phopley/rodney-project/Articles/tensorflow/test_image.jpg

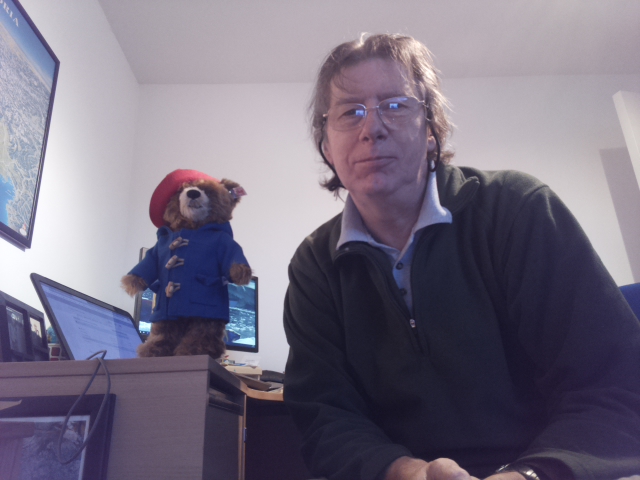
Articles/tensorflow/test_image.jpg
