phopley/rodney-project/Articles/tensorflow/Opt-person_dog.png

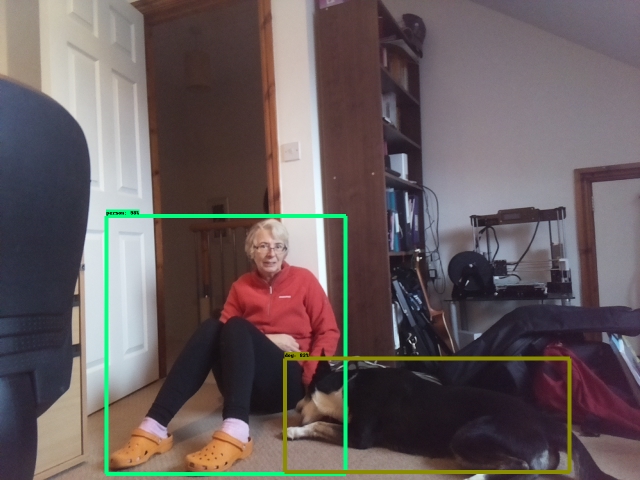
Articles/tensorflow/Opt-person_dog.png
