phopley/rodney-project/README.md

# rodney-project
Documentation for the Rodney House Robot project using ROS (Robot Operating System).

Please see the [project wiki](https://github.com/phopley/rodney-project/wiki) for more information
