phopley/rodney-project/Articles/Part08/pi_image.md

# Instructions for creating the Raspberry Pi image
## Introduction
These steps will guide you through the process of installing and setting up the Rapberry Pi image for the Rodney project. We will use a free lbuntu image from Ubiquity Robotics. This image included ROS Kinetic and there own ROS packages like raspicam_node.

In the guide we will
* [Obtain and copy the Ubiquity Robotics Pi image](https://github.com/phopley/rodney-project/blob/master/Articles/Part08/pi_image.md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)
* [Configure and update the image](https://github.com/phopley/rodney-project/blob/master/Articles/Part08/pi_image.md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)
* N/A
* [Setup Bluetooth](https://github.com/phopley/rodney-project/blob/master/Articles/Part08/pi_image.md#4-setup-bluetooth)
* [Configure the System](https://github.com/phopley/rodney-project/blob/master/Articles/Part08/pi_image.md#5-configure-the-system)
* [Install Homer Robot Face](https://github.com/phopley/rodney-project/blob/master/Articles/Part08/pi_image.md#6-install-homer-robot-face)
* [Install Voice Applications](https://github.com/phopley/rodney-project/blob/master/Articles/Part08/pi_image.md#7-install-voice-applications)
* [Install ROS pakages used by Rodney](https://github.com/phopley/rodney-project/blob/master/Articles/Part08/pi_image.md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)
* [Setup a Swapfile](https://github.com/phopley/rodney-project/blob/master/Articles/Part08/pi_image.md#9-setup-a-swapfile)
* [Install simple-pid](https://github.com/phopley/rodney-project/blob/master/Articles/Part08/pi_image.md#10-install-simple-pid)

## Steps
### 1. Obtain and copy the Ubiquity Robotics Pi image
Here we will download and install the image.
- [ ] Download the lastest ROS image from the Ubiquity Robotics web site https://downloads.ubiquityrobotics.com/pi.html. The last image I used was 2019-02-19-ubiquity-xenial-lxde-raspberry-pi.img.xz
- [ ] Unzip the image.
- [ ] Format a 16GB SD card. I use SD Card Formatter to format the card.
- [ ] Copy the unzipped image to the SD card. I use Win32DiskImager to create the image on an SD card.
- [ ] Boot the Pi from the SD card. When the Raspberry Pi boots for the first time it resizes the file system to fill the SD card. This can make the first boot take some time.
- [ ] Login to the Pi. The user name is 'ubuntu' and the password is 'ubuntu'.
### 2. Configure and update the image
- [ ] The image comes with a WiFi access point. The SSID is ubiquityrobotXXXX where XXXX is part of the MAC address, the wifi password is robotseverywhere. Since I'm developing an house robot I prefer to connect to my home Wi-Fi. Disconnect the WiFi from the access point and connect to the home WiFi network. SSH is enabled so it is possible to remotley login.
- [ ] There is an Ubiquity Robotics script designed for their own robots. Disable the script with the following shell command.
```
$ sudo systemctl disable magni-base
```
- [ ] Run the following commands to get the latest updates.
```
$ sudo apt-get update
$ sudo apt-get upgrade
$ sudo apt-get dist-upgrade
$ sudo reboot now
```
### 3. N/A
### 4. Setup Bluetooth
I like to use a small Bluetooth keyboard with the robot. In this image the Bluetooth is enabled correctly.
- [ ] Pair the device.
### 5. Configure the System
The following configures the lbunutu desktop and system for how I like it for a robot.
- [ ] So that you only have to touch 'login' on the screen and not enter a password to login select from the menu "System Tools -> Users and Groups", change to Password "Not asked on login"
- [ ] Although the image includes Firefox I like to install Chromium with:
```
$ sudo apt install chromium-browser
```
- [ ] I don't want the screen saver or power managment to kick in so from the menu "Preferences->Power Manager" select
* System tab - When inactive for -> never
* Display tab - Blank after -> never
* Display tab - Put to sleep after - > never
* Display tab - switch off after -> never
* Security tab - Automatically lock the session : Never
- [ ] You may want to change the user password.
- [ ] I like to set the following panel applets to my choice. Right click on bar and select "Add/Remove Panel Items" and select:
* Menu
* Directory Menu - "/home/ubuntu"
* Application Launch and Task Bar (stretch) - Chromium Web Browser
* System Tray
* Indicator applets
* Digital Clock
### 6. Install Homer Robot Face
The Homer Robot Face ROS package is used to display an animated robot face.
- [ ] Install the homer_robot_face package
```
$ sudo apt-get install ros-kinetic-homer-robot-face
```
- [ ] There is a problem with a directory path. The code expects the OGRE to be in the directory `/usr/lib/x86_64-linux-gnu/OGRE-1.9.0` but as you would expect on a Raspberry Pi it's in `/usr/lib/arm-linux-gnueabihf/OGRE-1.9.0` We can solve this problem by creating a symbolic link
```
$ cd /usr/lib
$ sudo mkdir -p x86_64-linux-gnu
$ sudo ln -s /usr/lib/arm-linux-gnueabihf/OGRE-1.9.0 /usr/lib/x86_64-linux-gnu
```
- [ ] You can configer the face by editing the robot_homer_face config.cfg file
```
sudo nano /opt/ros/kinetic/share/homer_robot_face/config/config.cfg
```
* Mesh Filename : GiGo
* Head Color : 1.0, 1.0, 1.0
* Iris Color : 0.0, 1.0, 1.0
* Outline Color : 0.0, 0.0, 0.0
* Voice : male
* Window Width : 400
* Window Height : 450
* Window Rotation : 0
- [ ] To centre the face when running. Edit the lubuntu-rc.xml file and add the following application tag inside the applications tag
```
$ cd ~/
$ nano .config/openbox/lubuntu-rc.xml
```
``` xml
        <application name="RobotFace">
            <position force="yes">
                <x>200</x>
                <y>0</y>
            </position>
        </application>
</applications>
</openbox_config>
```
### 7. Install Voice Applications
The applications `pico2wav` and `Sox` are used by Rodney.
- [ ]  Install pico2wav with the following command:
```
$ sudo apt-get install libttspico-utils
```
- [ ] Install Sox with the following command:
```
sudo apt-get install sox libsox-fmt-all
```
### 8. Install ROS pakages used by Rodney
The following ROS packages are also used by Rodney and can be download and installed/compiled.
- [ ] I usually use the directory ~/rondey_ws for the ROS wokspace, add it to the bash file with the following
```
$ cd ~/
$ nano .bashrc
```
* Add "source /home/ubuntu/rodney_ws/devel/setup.bash" to the end of the file, save and exit
- [ ] Install the rosserial package so that the Arduino or Teensy can be used
```
$ sudo apt-get install ros-kinetic-rosserial
```
- [ ] Install the laser_filters package so that we can bound the LIDAR scan
```
$ sudo apt-get install ros-kinetic-laser-filters
```
- [ ] Install the robot_localization package
```
$ sudo apt-get install ros-kinetic-robot-localization
```
- [ ] Install the map_server, amcl packages
```
$ sudo apt-get install ros-kinetic-map-server ros-kinetic-amcl
```
- [ ] Install the global and local planners
```
$ sudo apt-get install ros-kinetic-global-planner ros-kinetic-dwa-local-planner
```
- [ ] Rodney use the ros-keyboard package for keyboard teleop. It requires SDL version 1.2. If you just try to install SDL you will get a later version and the package will not build. Use the following commands to download the package from https://github.com/lrse/ros-keyboard and use rosdep to ensure the correct dependencies are installed before building it with catkin_make.
* Note - I have assumed the package was download to ~/git/ros-keyboard
```
$ mkdir -p ~/temp_ws/src
$ cd ~/temp_ws
$ catkin_make
$ ln -s ~/git/ros-keyboard ~/temp_ws/src
$ rosdep update
$ rosdep install --from-paths src --ignore-src --rosdistro kinetic -y
$ catkin_make
```
### 9. Setup a Swapfile
As the project develops and increases in size a swapfile is required when building the project. Create a 1GB swapfile with the following command:
```
$ cd /
$ sudo dd if=/dev/zero of=swapfile bs=1M count=1000
$ sudo mkswap swapfile
$ sudo swapon swapfile
$ sudo nano etc/fstab
```
* Add "/swapfile none swap sw 0 0" to the end of the file , save and exit
### 10. Install simple-pid
The thunderborg node uses the simple-pid https://pypi.org/project/simple-pid/
This can be installed with
```
$ pip install simple-pid
```
