phopley/rodney-project/Articles/Part03/Opt-IMG_0395.JPG

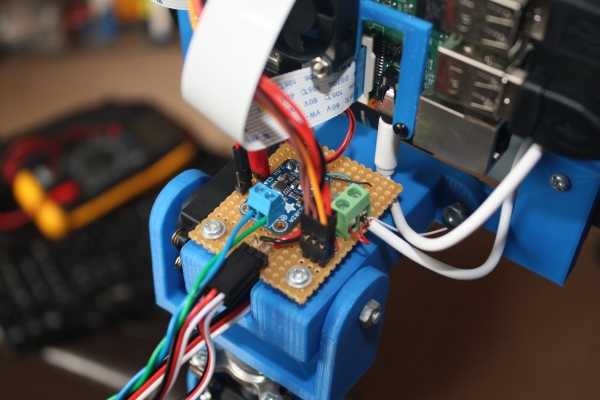
Articles/Part03/Opt-IMG_0395.JPG
