phopley/rodney-project/Articles/Part03/Opt-IMG_0396.JPG

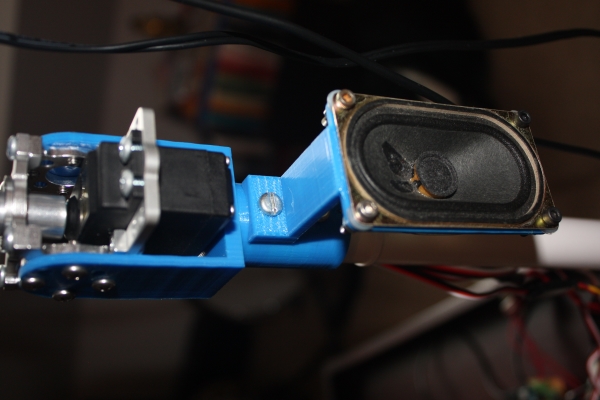
Articles/Part03/Opt-IMG_0396.JPG
