phopley/rodney-project/Articles/Part03/Opt-rodney_face.png

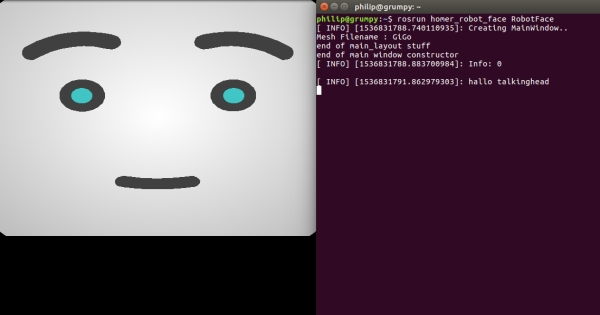
Articles/Part03/Opt-rodney_face.png
