phopley/rodney-project/Articles/Part03/Opti-reconfigure_speech_node.png

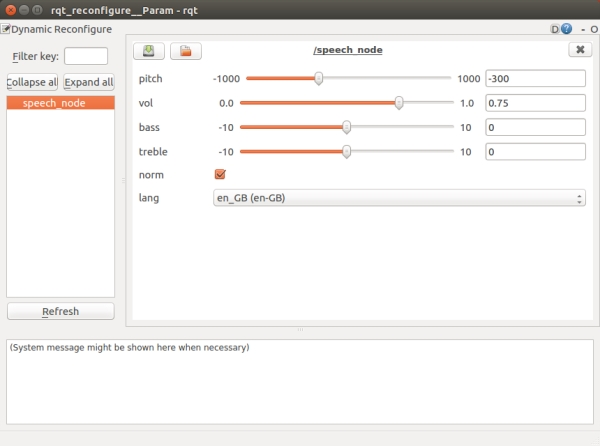
Articles/Part03/Opti-reconfigure_speech_node.png
