phopley/rodney-project/Articles/Part03/Opti-sim01.png

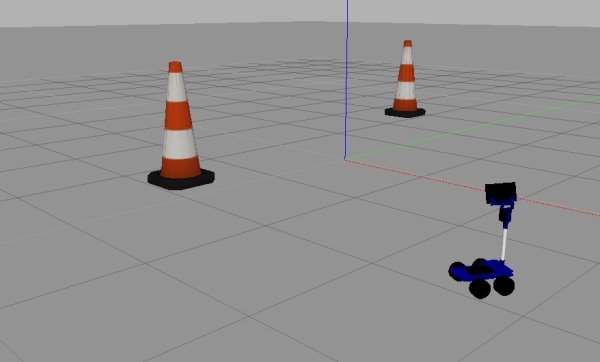
Articles/Part03/Opti-sim01.png
