phopley/rodney-project/Articles/Part05/Optimized-IMG_0496.JPG

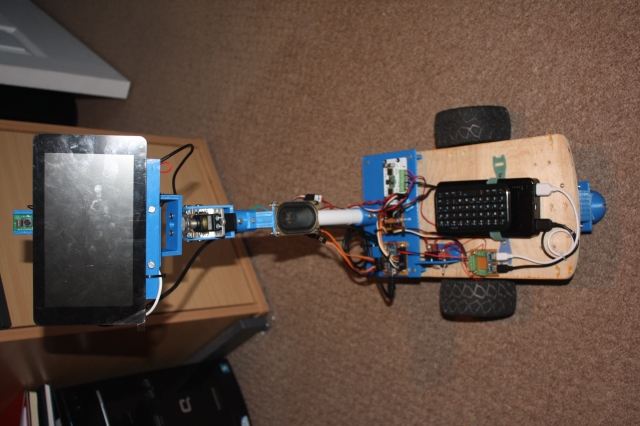
Articles/Part05/Optimized-IMG_0496.JPG
