phopley/rodney-project/Articles/Part08/Opti-smach_mission1.png

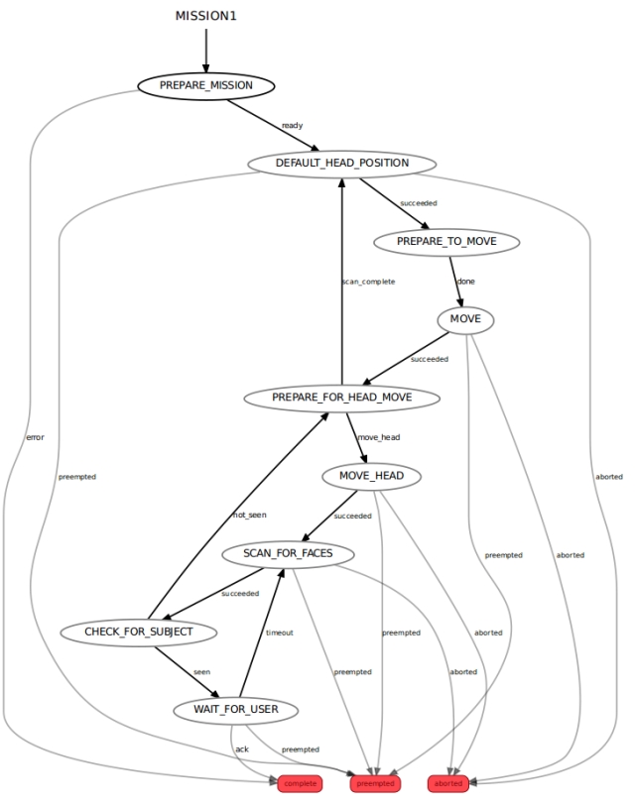
Articles/Part08/Opti-smach_mission1.png
