phopley/rodney-project/Articles/Part08/Opti-smach_mission4.png

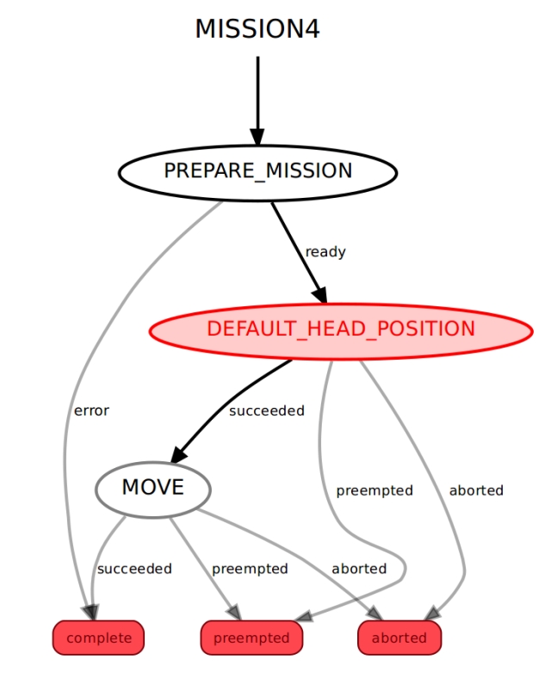
Articles/Part08/Opti-smach_mission4.png
