phopley/rodney-project/Articles/tensorflow/Opt-rosgraph.png

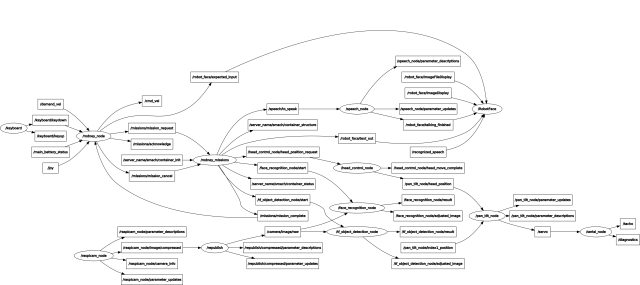
Articles/tensorflow/Opt-rosgraph.png
