phopley/rodney-project/Articles/tensorflow/rosgraph.png

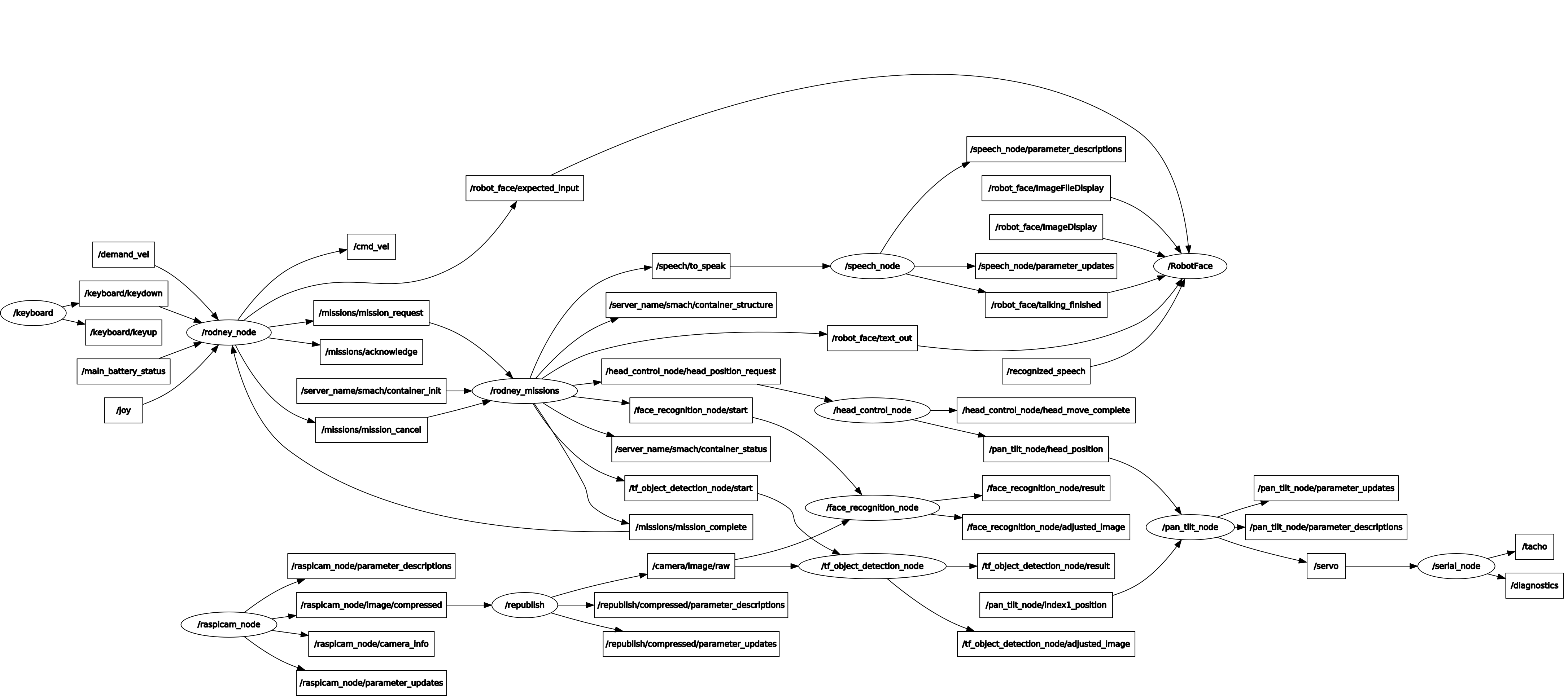
Articles/tensorflow/rosgraph.png
