phopley/rodney-project/Articles/tensorflow/tensorwordcloud.jpg

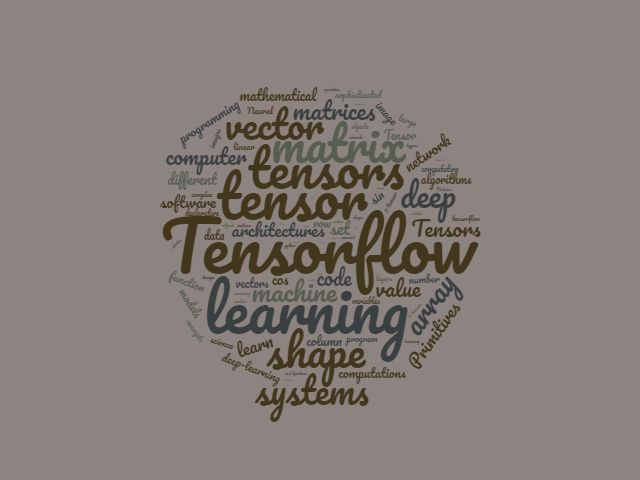
Articles/tensorflow/tensorwordcloud.jpg
