phopley/rodney-project/Articles/Part05/bom.md

# Rodney Robot BOM (Article Part 5)
| Item | No. | Approx Cost |
| --- | ----| --- |
| [3D Print Camera bracket](https://github.com/phopley/rodney-project/blob/master/hardware/3D%20Prints/camera%20bracketV2.stl) | x1 | |
| [3D Print Caster](https://github.com/phopley/rodney-project/blob/master/hardware/3D%20Prints/pingpongwheelBeefy.stl) | x2 |  |
| [3D Print Caster Spacer](https://github.com/phopley/rodney-project/blob/master/hardware/3D%20Prints/casterspacer2.stl) | x2 |  |
| [3D Print Display Bracket](https://github.com/phopley/rodney-project/blob/master/hardware/3D%20Prints/display%20bracket_vb.stl) |x1| |
| [3D Print Fan Bracket](https://github.com/phopley/rodney-project/blob/master/hardware/3D%20Prints/fan_bracket.stl) | x1 | |
| [3D Print Head Fixing Bracket](https://github.com/phopley/rodney-project/blob/master/hardware/3D%20Prints/head%20fixing.stl) | x1 |  |
| [3D Print Head Pan Bracket](https://github.com/phopley/rodney-project/blob/master/hardware/3D%20Prints/pan%20bracket_vb.stl) | x1 |  |
| [3D Print Head Tilt Arm](https://github.com/phopley/rodney-project/blob/master/hardware/3D%20Prints/tilt%20arm_vb.stl) | x1 | | 
| [3D Print Rear Platform](https://github.com/phopley/rodney-project/blob/master/hardware/3D%20Prints/smallRearPlatform.stl) | x1 |  |
| [3D Print Rear Platform Standoff](https://github.com/phopley/rodney-project/blob/master/hardware/3D%20Prints/platformStandoffs23.stl) | x4 |  |
| [3D Print Speaker Bracket](https://github.com/phopley/rodney-project/blob/master/hardware/3D%20Prints/speaker_bracket.stl) | x1 | |
| [3D Print Switch Bracket](https://github.com/phopley/rodney-project/blob/master/hardware/3D%20Prints/switchBracket.stl)| x1 |  |
| 16GB Miscro SD Card | x1  |  £8.00 |
| [2 Pole 5mm Pitch PCB Mount Screw Terminal Block](https://www.amazon.co.uk/20Pcs-Pitch-Mount-Screw-Terminal-Green/dp/B00I00OHHY)| Pack 20  | £1.45 |
| 21.5mm PVC Pipe (used for neck) | | £1.89 for 2 metres  |
| 6-32 UNC x 5/16 inch Pan Head Screws (Head Bracket to Load Bearing Block) | x8 | |
| 8 Ohm Speaker | x1  | |
| AA Rechargeable Batteries | x10 | |
| [Adafruit Mono 2.5W Class D Audio Amplifier PAM8302](https://thepihut.com/products/adafruit-mono-2-5w-class-d-audio-amplifier-pam8302) | x1  | £4 |
| [Advanced Motor Bracket Mount (large)](https://www.modmypi.com/motors-mounts-and-wheels-1140/advanced-motor-bracket-mount-large) | x2  | £7.98 |
| [Arduino Nano](https://uk.rs-online.com/web/p/products/6961667) | x1  |  £19.26 |
| Assorted 3-pin Female/Female cables | | | 
| Audio lead | x1  | |
| Base - plywood board 340x180x8 mm | x1  | |
| [Battery Holder (10 x AA)](https://www.modmypi.com/raspberry-pi/robotics-and-motor-controllers-392/battery-snaps-and-boxes-1165/10aa-holder) | x1 | £3.00 |
| Black Cable Ties 2.5mm | Pack 100 |  £0.79 |
| [Brass Motor Shaft Hub - 6mm](https://www.modmypi.com/motors-mounts-and-wheels-1140/hub-6mm) | x2  | £3.98 |
| [Load Bearing Servo block (Futaba)](https://www.robotshop.com/uk/load-bearing-servo-block-futaba.html)| x1  | £26.78 |
| [Metal DC Geared Motor w/Encoder - 12V 122RPM 38Kg.cm](https://thepihut.com/products/metal-dc-geared-motor-w-encoder-12v-122rpm-38kg-cm)| x2  | £62 |
| Micro USB Breakout Board | x2 |  |
| Micro USB Power Cables | x2 |  |
| [Mini Bluetooth Keyboard](https://www.amazon.co.uk/Remaxm-Rechargeable-Bluetooth-Keyboards-Raspberry/dp/B07M7VQVDJ/) | x1 | £7.51 |
| [Miniature 5V Cooling Fan for Pi](https://thepihut.com/products/adafruit-miniature-5v-cooling-fan-for-raspberry-pi-and-other-computers)| x1  | £3.50 |
| Pi/Nano USB Cable | x1  | |
| [Raspberry Pi 3 7" Touchscreen Display](https://thepihut.com/products/official-raspberry-pi-7-touchscreen-display)| x1  | £60.00 |
| [Raspberry Pi 3, Model B, 1GB RAM](https://thepihut.com/collections/raspberry-pi/products/raspberry-pi-3-model-b)| x1  |  £32.00|
| [Raspberry Pi Camera Board V2](https://www.modmypi.com/pis-and-peripherals-1139/raspberry-pi-camera-board-v2-8mp1080p)| x1  | £24.50 |
| [Raspberry Pi Heatsink - Black](https://thepihut.com/products/raspberry-pi-heatsink)| x1  | £1 |
| [RC Servo Futaba S3003](https://www.modmypi.com/raspberry-pi/robotics-and-motor-controllers-392/motors-1022/servo-motor-futaba-s3003-multi-purpose-standard-size) | x1  | £7.00 |
| [RC Servo Futaba S3305 Heavy Duty Metal Gear](https://www.servoshop.co.uk/index.php?pid=FUTS3305&area=Servo) | x1 | £36.99 |
| Screw button head hex M2.5 x 16mm (fan bracket to Pi) | x2 | |
| [Single Row 40 Pin 2.54 mm Male Pin Header Connector](https://www.amazon.co.uk/Pack-Single-2-54-Header-Connector/dp/B06XR8CV8P) | Pack 50 | £5.85 |
| Switch - Rocker single pole | x1 | |
| Switch - Toggle double pole | x1 | |
| Table Tennis Balls | x2|  |
| [Thunderborg - Dual 5A Motor Controller with DC/DC & RGB LED](https://www.modmypi.com/motor-control-1135/thunderborg)| x1  | £37.00 |
| USB Power Bank, 2 port (2.1A, 1.0A) | x1 | |
| Various general screws/nuts/standoffs |  |  |
| Velcro Straps | | | 
| Veroboard - various | | |
| [Wheel Pair in Black (105x50mm)](https://www.modmypi.com/motors-mounts-and-wheels-1140/wheel-pair-in-black-105mm-x-50mm-) | x1 | £11.99|

[The Pi Hut](https://thepihut.com/)  
[ModMyPi](https://www.modmypi.com/)  
[Servo Shop](https://www.servoshop.co.uk/index.php)  
[Robot Shop](https://www.robotshop.com/uk/)  
[RS Components](https://uk.rs-online.com/web/)  
[Amazon](https://www.amazon.co.uk)
