phopley/rodney-project/hardware/3D Prints/push_button_bracket.stl

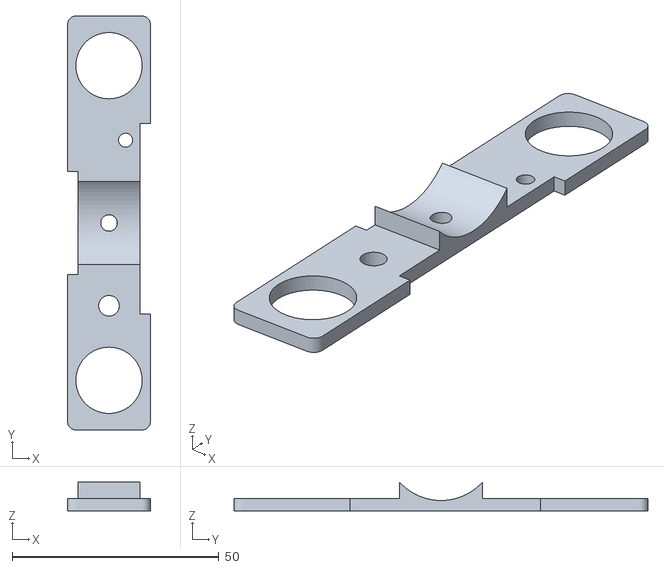
[picture p73: CAD file, 2019-04-29]
hardware/3D Prints/push_button_bracket.stl
20.0 x 100.0 x 6.93
