phopley/rodney-project/hardware/3D Prints/imu_support.stl

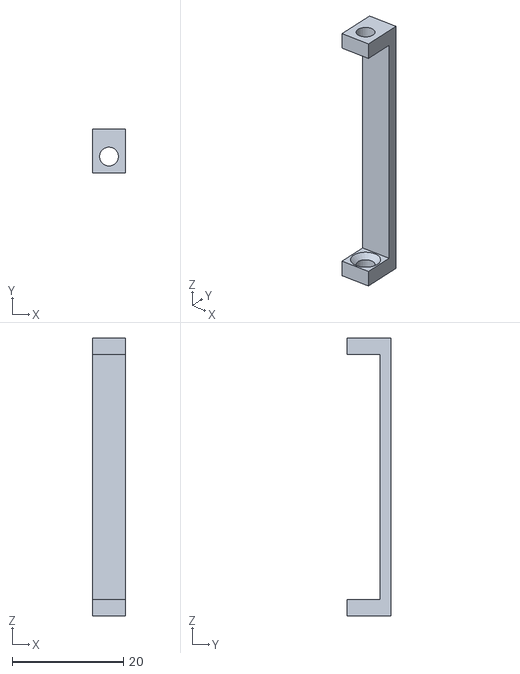
[picture p74: CAD file, 2019-04-09]
hardware/3D Prints/imu_support.stl
6.00 x 8.00 x 50.0
