phopley/rodney-project/hardware/3D Prints/imu_bracket.stl

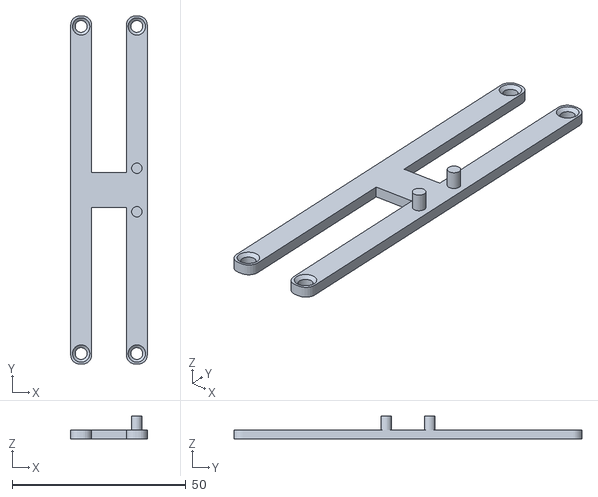
[picture p75: CAD file, 2019-04-09]
hardware/3D Prints/imu_bracket.stl
22.0 x 100.0 x 6.50
