phopley/rodney-project/hardware/3D Prints/fwdPlatform.stl

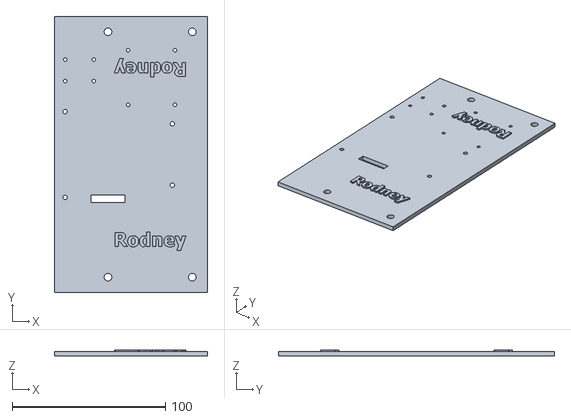
[picture p76: CAD file, 2019-03-01]
hardware/3D Prints/fwdPlatform.stl
100.0 x 180.0 x 4.00
