phopley/rodney-project/hardware/3D Prints/FwdPlatformStandoffs.stl

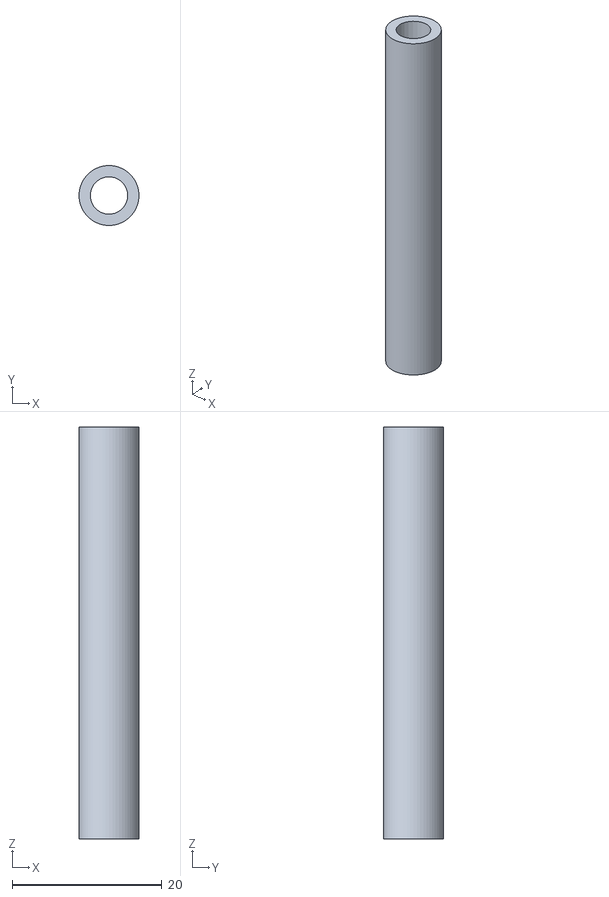
[picture p77: CAD file, 2019-02-13]
hardware/3D Prints/FwdPlatformStandoffs.stl
8.00 x 8.00 x 55.0
