phopley/rodney-project/hardware/3D Prints/smallRearPlatform.stl

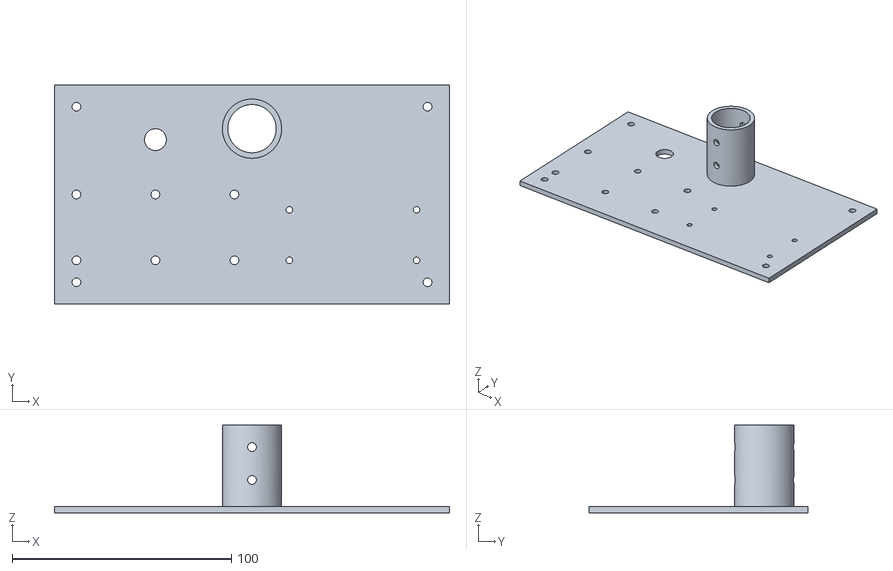
[picture p78: CAD file, 2019-01-29]
hardware/3D Prints/smallRearPlatform.stl
180.0 x 100.0 x 40.0
