phopley/rodney-project/hardware/3D Prints/platformStandoffs23.stl

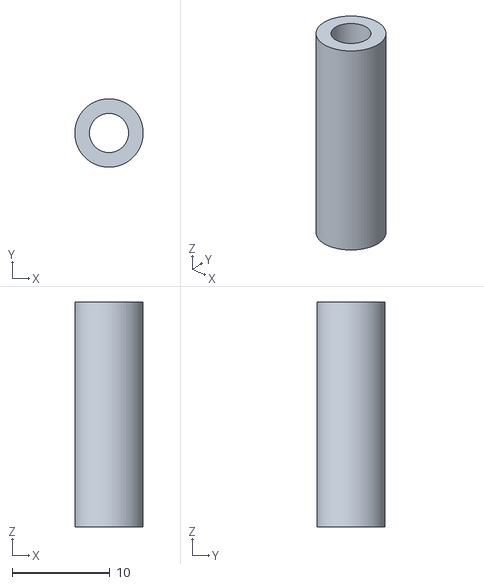
[picture p79: CAD file, 2019-01-29]
hardware/3D Prints/platformStandoffs23.stl
7.00 x 7.00 x 23.0
