phopley/rodney-project/hardware/3D Prints/switchBracket.stl

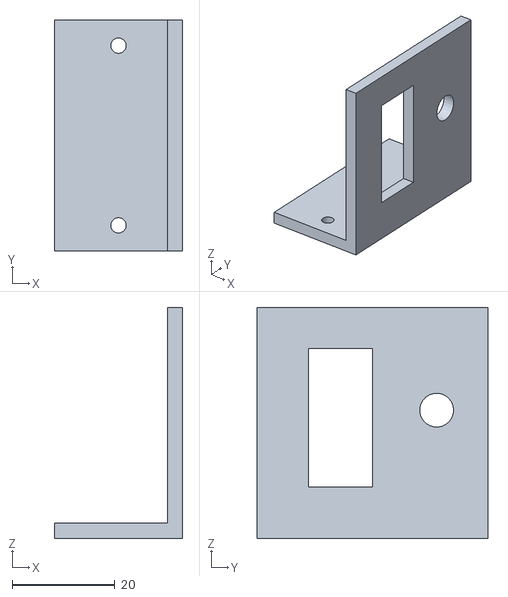
[picture p80: CAD file, 2019-01-29]
hardware/3D Prints/switchBracket.stl
25.0 x 45.0 x 45.0
