phopley/rodney-project/hardware/3D Prints/casterspacer2.stl

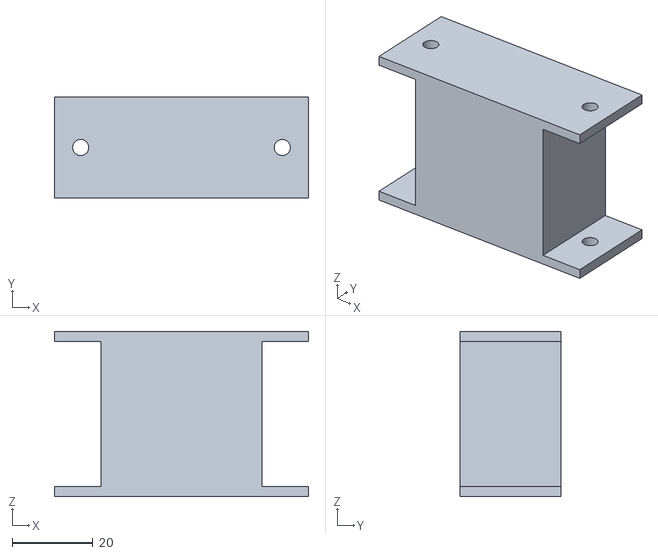
[picture p81: CAD file, 2019-01-29]
hardware/3D Prints/casterspacer2.stl
63.0 x 25.0 x 41.0
