phopley/rodney-project/hardware/3D Prints/pingpongwheelBeefy.stl

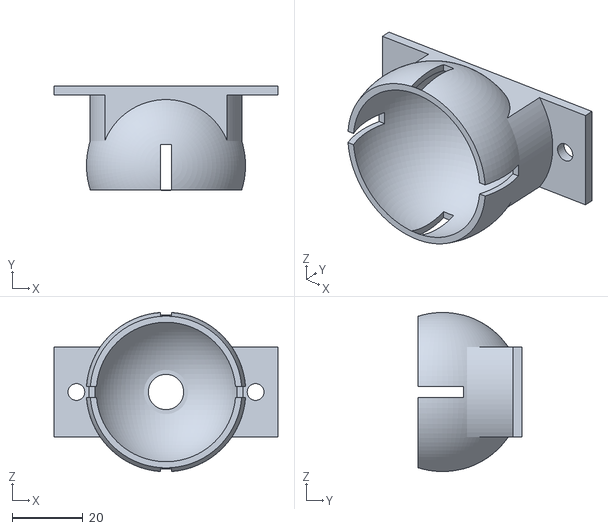
[picture p82: CAD file, 2019-01-29]
hardware/3D Prints/pingpongwheelBeefy.stl
63.5 x 29.6 x 45.1
