phopley/rodney-project/hardware/3D Prints/tilt arm_vb.stl

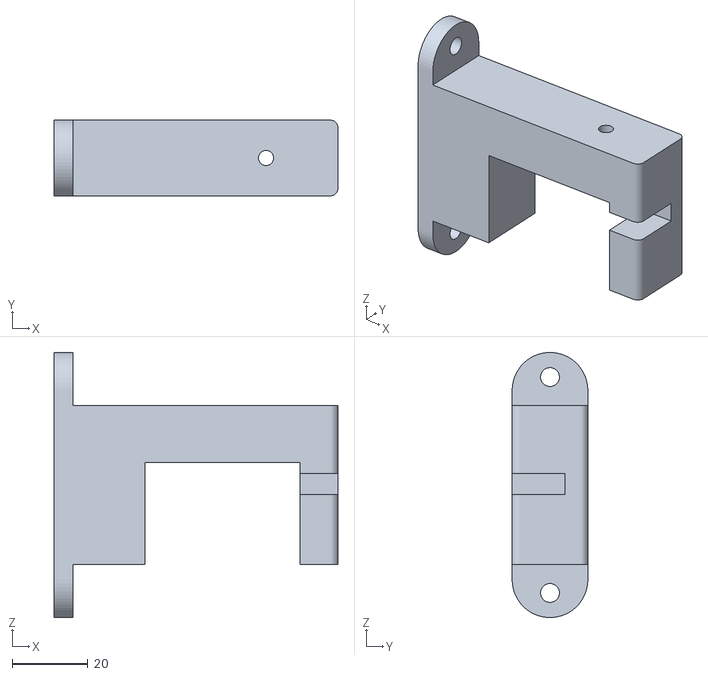
[picture p83: CAD file, 2018-09-14]
hardware/3D Prints/tilt arm_vb.stl
75.0 x 20.0 x 70.0
