phopley/rodney-project/hardware/3D Prints/speaker_bracket.stl

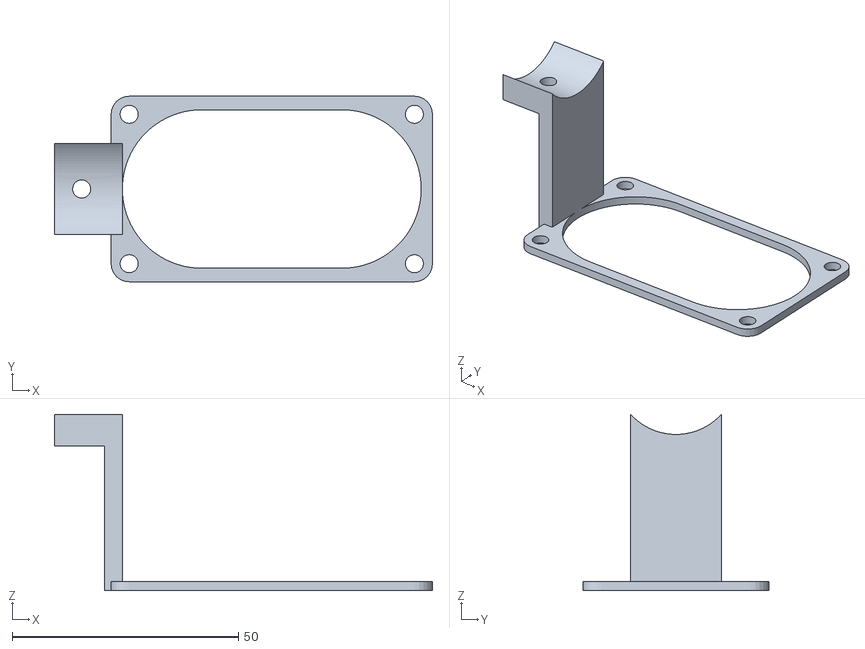
[picture p84: CAD file, 2018-09-14]
hardware/3D Prints/speaker_bracket.stl
83.5 x 41.0 x 38.9
