phopley/rodney-project/hardware/3D Prints/display bracket_vb.stl

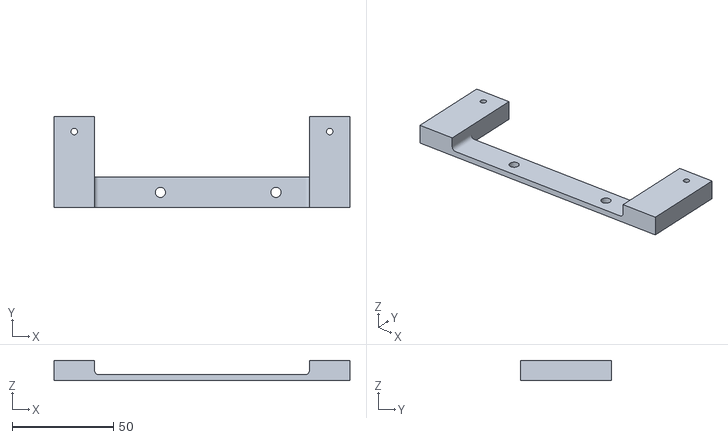
[picture p85: CAD file, 2018-09-14]
hardware/3D Prints/display bracket_vb.stl
146.0 x 45.0 x 10.0
