phopley/rodney-project/hardware/3D Prints/head fixing.stl

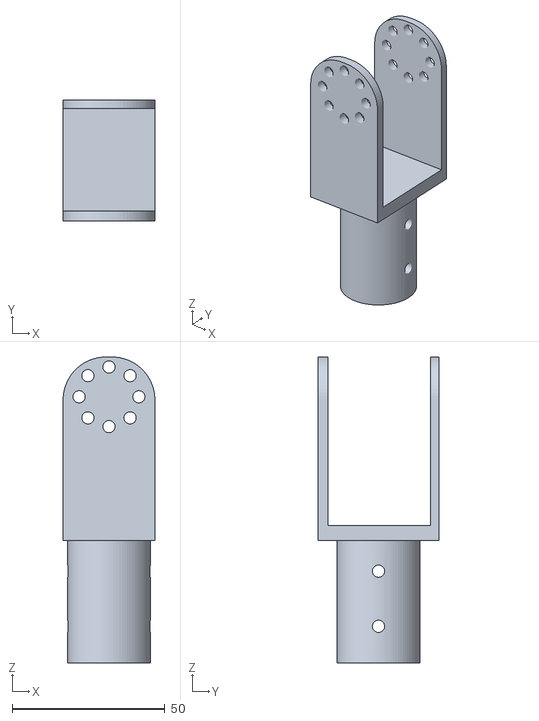
[picture p86: CAD file, 2018-09-14]
hardware/3D Prints/head fixing.stl
30.0 x 39.5 x 100.0
