phopley/rodney-project/hardware/3D Prints/fan_bracket.stl

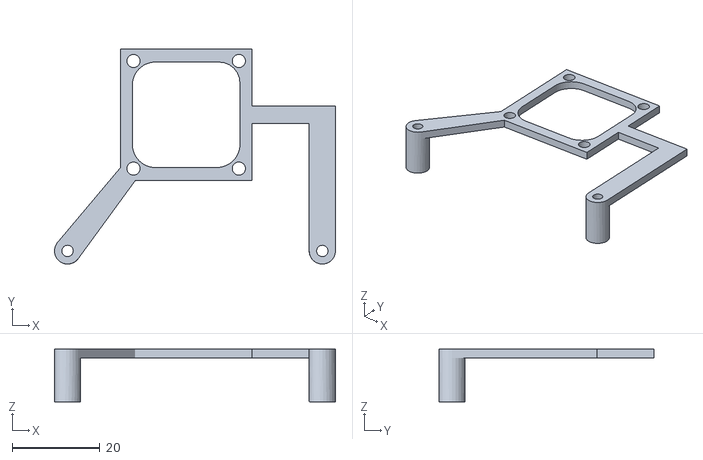
[picture p87: CAD file, 2018-09-14]
hardware/3D Prints/fan_bracket.stl
64.0 x 49.0 x 12.0
