phopley/rodney-project/hardware/3D Prints/pan bracket_vb.stl

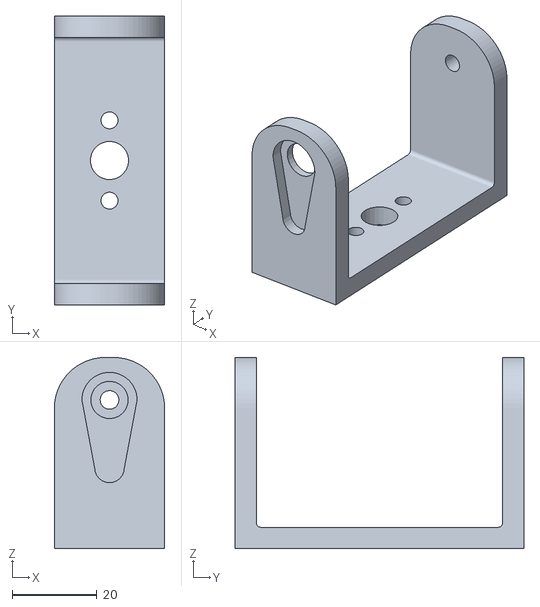
[picture p88: CAD file, 2018-09-14]
hardware/3D Prints/pan bracket_vb.stl
26.0 x 68.0 x 45.0
