phopley/rodney-project/hardware/3D Prints/camera bracketV2.stl

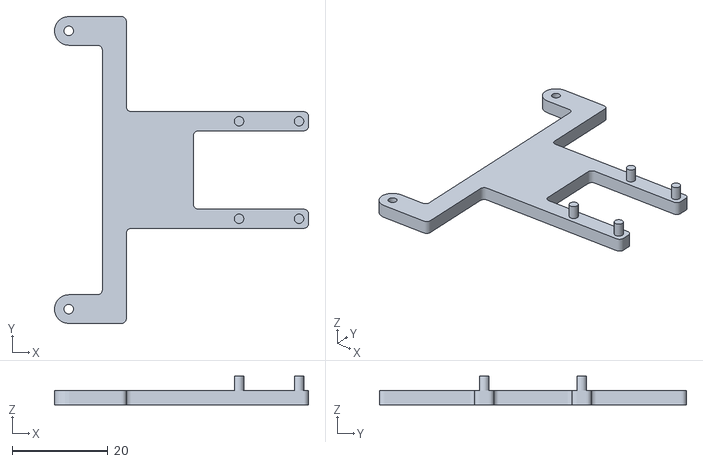
[picture p89: CAD file, 2018-08-17]
hardware/3D Prints/camera bracketV2.stl
53.0 x 64.0 x 6.00
