phopley/rodney-project/Articles/Part03/Opti-voice_test_graph.png

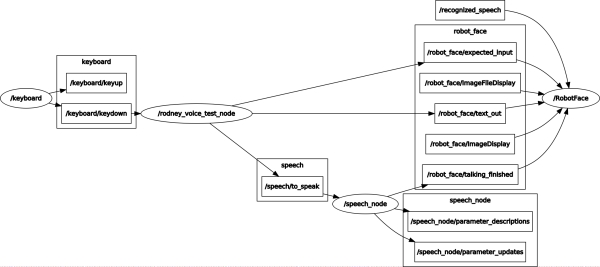
Articles/Part03/Opti-voice_test_graph.png
