phopley/rodney-project/(threads)

Thread 1 (2019-01-14):

Push button for default head position

phopley, 2019-01-14:
Add a push button to the robot so that when activated the rodney node publishes a message on the /mission_request topic with the data set to "J3^c^-". This will result in the head moving to the default position.

phopley, 2019-04-18:
Raspberry Pi Python code to use GPIO
https://raspberrypihq.com/use-a-push-button-with-raspberry-pi-gpio/
Use GPIO event

phopley, 2019-04-23:
Code added with new pi_io package and changes to rodney and rodney_missions packages

Closed 2019-04-23.

Thread 2 (2019-02-28):

odom transform should include the 'z' value above the ground

phopley, 2019-02-28:
The odom transform value should include the 'z' value of the base_link above odom. This is fixed and is 0.090. Should this value just be a fixed value for should we read it from the urdf model some how?

phopley, 2019-03-17:
Changes made for V0.3.0 of the rodney package and V0.2.0 of thunderborg package which included adding the EKF and the foot print frame

Closed 2019-03-17.

Thread 5 (2019-03-16):

Servo chatter at 116 degrees

phopley, 2019-03-16:
Can we solve the head pan servo chatter at 116 degrees which is happening on the Teensy? Do we need a level shifter for the PWM signal

Thread 6 (2019-03-16):

Add IMU and EKF to improve odom and odom tf

phopley, 2019-03-16:
Add IMU and Extended Kalman Filter to improve odom message and odom tf

phopley, 2019-03-17:
EKF added to project but still need to feed it with IMU data when IMU added to project.

phopley, 2019-04-15:
Work complete

Closed 2019-04-15.

Thread 7 (2019-03-16):

Add LED indication of manual or auto mode

phopley, 2019-03-16:
LED indication when either manual or autonomous mode (two colour LED). Can the Teensy/Arduino handle a service. This service could be to turn both colours off, either on or the other on or both on. rodney node could then call this service.

phopley, 2019-04-18:
Or we could use the GPIO on the Raspberry Pi. There is most likely to be a new node written in Python to read from and write to the GPIO.

phopley, 2019-04-23:
Code added with new pi_io package and changes to rodney package

Closed 2019-04-23.

Thread 8 (2019-03-17):

Add EKF to get IMU ready to improve odom

phopley, 2019-03-17:
Update thunderborg to publish /raw_odom instead of /odom and to not broadcast the odom tf. Add an EKF node to take the /raw_odom and produce /odom and odom tf. It will also in the future take the output of an IMU to fuse data and produce an improved ODOM.

phopley, 2019-03-17:
Change completed in version V0.3.0 of rodney package and V0.2.0 of thunderborg package

Closed 2019-03-17.
