phopley/rodney-project/(commit log)

2018-08-17 Added 3D Print folder
    [camera bracketV2.stl]
2018-08-18 Adding bom
    [camera bracketV2.stl]
2018-09-14 Moving harware to rodney-project
    [display bracket_vb.stl, fan_bracket.stl, head fixing.stl, pan bracket_vb.stl, speaker_bracket.stl, tilt arm_vb.stl]
2018-09-14 Moved circuit diagram to here
    [Rodney.fzz]
2018-10-29 Added circuit diagram components
2018-10-29 Added servo motor
    [servo_motor.xml]
2018-11-01 Working on circuit diagrams
2018-12-01 Updated power management settings
2019-01-29 Adding article 5
    [casterspacer2.stl, pingpongwheelBeefy.stl]
2019-01-29 Added more 3D prints
    [platformStandoffs23.stl, smallRearPlatform.stl]
2019-01-29 Create BOM for part 5
2019-01-30 Update to circuit diagram
    [motor_hall_sensor.xml]
2019-02-13 Adding updated fwd platform
    [FwdPlatformStandoffs.stl, fwdPlatform.stl]
2019-03-03 Added laser_filters package
2019-03-15 Updated bom and pi image for aricle 6
2019-03-16 bom moved to wiki
2019-03-16 Moved circuit to wiki
2019-04-09 Update to circuit diagram
    Adding LIDAR and IMU to circuit. Replaced Nano with Teensy
2019-04-09 Added IMU bracket stl files
    [imu_bracket.stl, imu_support.stl]
2019-04-09 Updated BOM for part 6
2019-04-29 Update to circuit
    Added push buttons and bi-LED
